MarcusViniciusTEC/PowerSupllyCC_CV/README.md

# PowerSupllyCC_CV

layout fonte CC/CV, controlado por STM32F103 e display 128x64
