MarcusViniciusTEC/PowerSupllyCC_CV/FONTE_V2.kicad_pcb

## KiCad design FONTE_V2.kicad_pcb (2025-01-29)

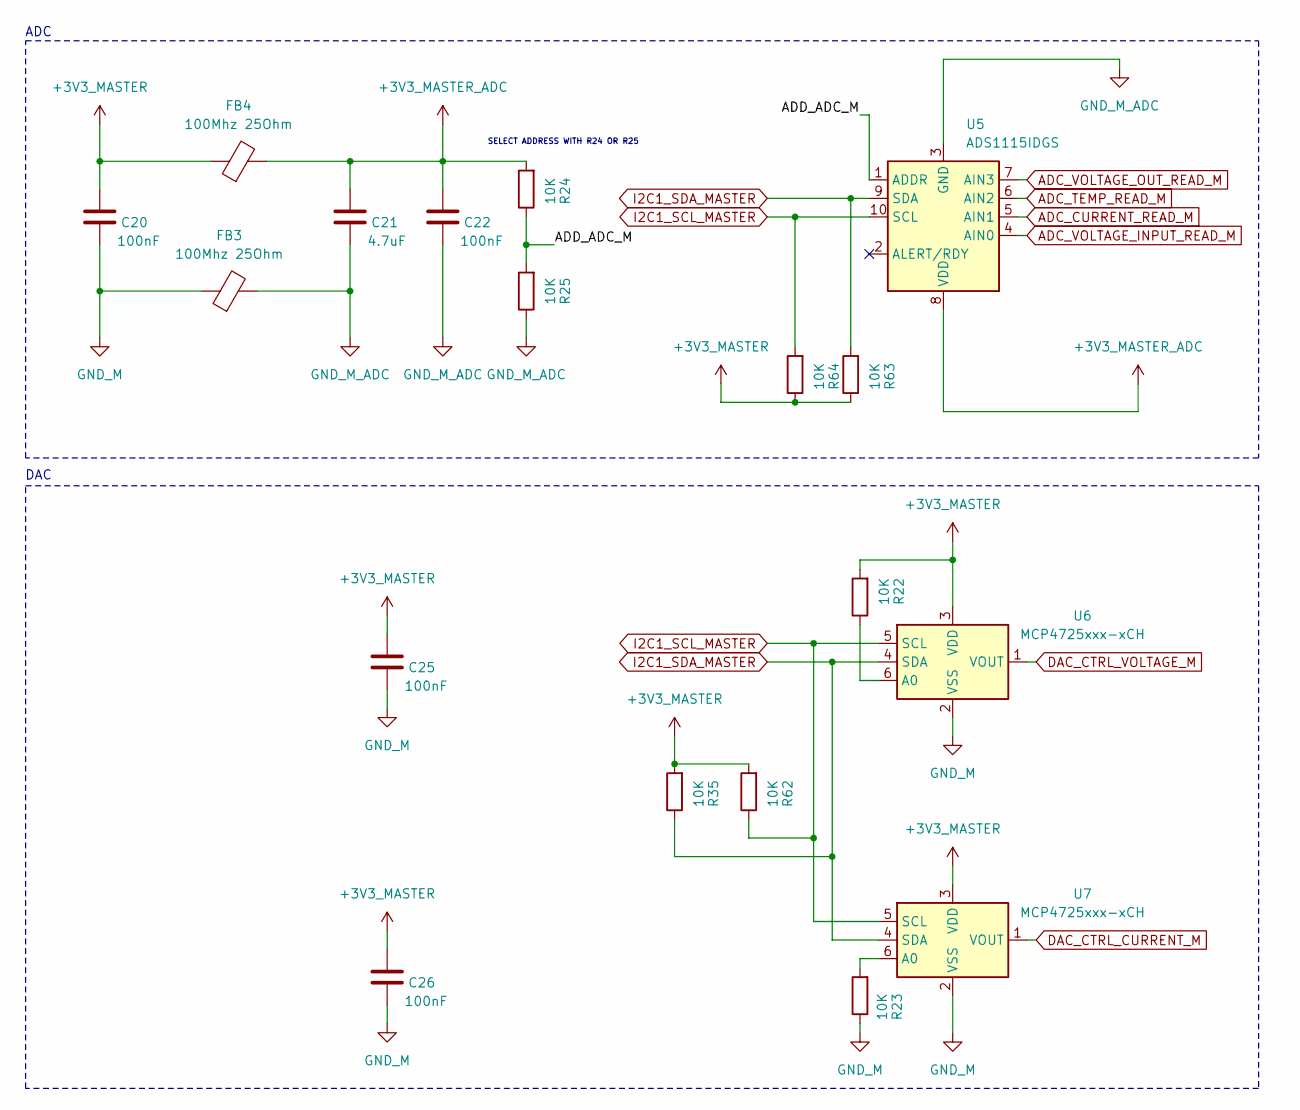
[picture p1: schematic DAC_ADC_MASTER.kicad_sch, FONTE CC/CV MICROCONTROLADA]

Parts:
C20, C22, C25, C26: 100nF; C_0805_2012Metric_Pad1.18x1.45mm_HandSolder
C21: 4.7uF; C_0805_2012Metric_Pad1.18x1.45mm_HandSolder
FB3, FB4: 100Mhz 25Ohm; L_0805_2012Metric_Pad1.15x1.40mm_HandSolder
R22, R23, R24, R25, R35, R62, R63, R64: 10K; R_0805_2012Metric_Pad1.20x1.40mm_HandSolder
U5: ADS1115IDGS; TSSOP-10_3x3mm_P0.5mm
U6, U7: MCP4725xxx-xCH; SOT-23-6

Connections:
+3V3_MASTER: C20.1, C25.1, C26.1, FB4.1, R22.2, R35.2, R62.2, R63.1, R64.1, U6.3 (VDD), U7.3 (VDD); also elsewhere on the board
+3V3_MASTER_ADC: C21.1, C22.1, FB4.2, R24.2, U5.8 (VDD)
/DAC_ADC_MASTER/ADD_ADC_M: R24.1, R25.2, U5.1 (ADDR)
ADC_CURRENT_READ_M: U5.5 (AIN1); also elsewhere on the board
ADC_TEMP_READ_M: U5.6 (AIN2); also elsewhere on the board
ADC_VOLTAGE_INPUT_READ_M: U5.4 (AIN0); also elsewhere on the board
ADC_VOLTAGE_OUT_READ_M: U5.7 (AIN3); also elsewhere on the board
DAC_CTRL_CURRENT_M: U7.1 (VOUT); also elsewhere on the board
DAC_CTRL_VOLTAGE_M: U6.1 (VOUT); also elsewhere on the board
GND_M_ADC: C21.2, C22.2, FB3.2, R25.1, U5.3 (GND)
I2C1_SCL_MASTER: R62.1, R64.2, U5.10 (SCL), U6.5 (SCL), U7.5 (SCL); also elsewhere on the board
I2C1_SDA_MASTER: R35.1, R63.2, U5.9 (SDA), U6.4 (SDA), U7.4 (SDA); also elsewhere on the board
unnamed: R22.1, U6.6 (A0)
unnamed: R23.2, U7.6 (A0)

Notes on the sheet:
SELECT ADDRESS WITH R24 OR R25
ADC
DAC

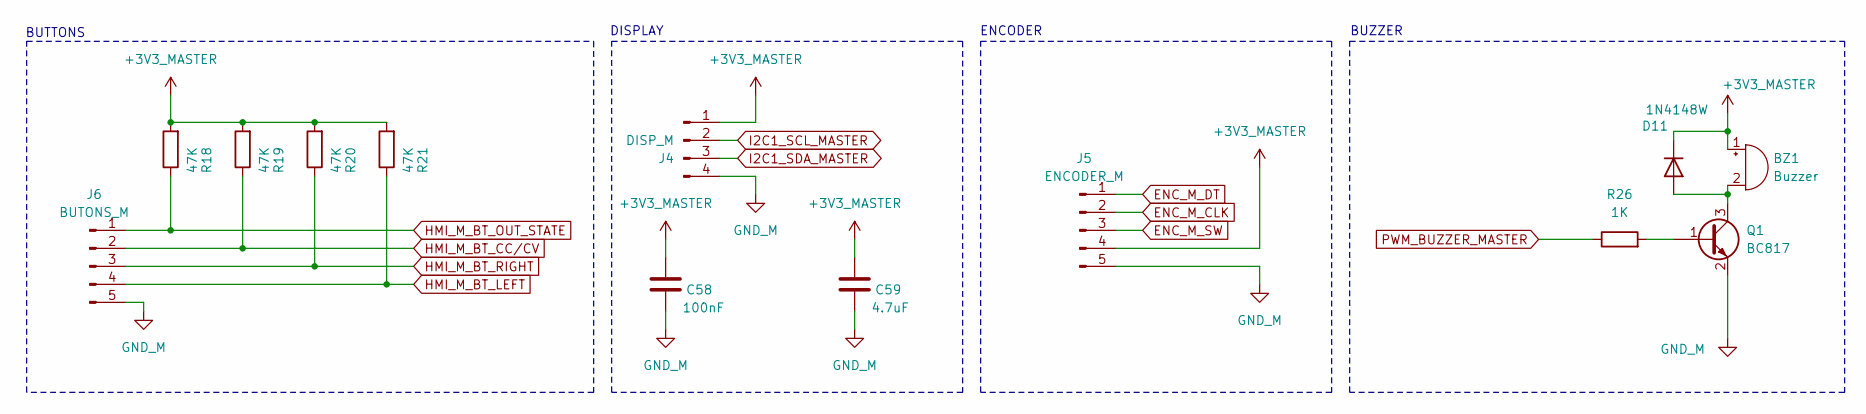
[picture p2: schematic HMI_MASTER.kicad_sch, FONTE CC/CV MICROCONTROLADA]

Parts:
BZ1: Buzzer; Buzzer_12x9.5RM7.6
C58: 100nF; C_0805_2012Metric_Pad1.18x1.45mm_HandSolder
C59: 4.7uF; C_0805_2012Metric_Pad1.18x1.45mm_HandSolder
D11: 1N4148W; D_SOD-123
J4: DISP_M; PinSocket_1x04_P2.54mm_Vertical
J5: ENCODER_M; PinHeader_1x05_P2.54mm_Vertical
J6: BUTONS_M; PinHeader_1x05_P2.54mm_Vertical
Q1: BC817; SOT-23
R18, R19, R20, R21: 47K; R_0805_2012Metric_Pad1.20x1.40mm_HandSolder
R26: 1K; R_0805_2012Metric

Connections:
+3V3_MASTER: BZ1.1 (+), C58.1, C59.1, D11.1 (K), J4.1, J5.4, R18.2, R19.2, R20.2, R21.2; also elsewhere on the board
ENC_M_CLK: J5.2; also elsewhere on the board
ENC_M_DT: J5.1; also elsewhere on the board
ENC_M_SW: J5.3; also elsewhere on the board
HMI_M_BT_CC/CV: J6.2, R19.1; also elsewhere on the board
HMI_M_BT_LEFT: J6.4, R21.1; also elsewhere on the board
HMI_M_BT_OUT_STATE: J6.1, R18.1; also elsewhere on the board
HMI_M_BT_RIGHT: J6.3, R20.1; also elsewhere on the board
I2C1_SCL_MASTER: J4.2; also elsewhere on the board
I2C1_SDA_MASTER: J4.3; also elsewhere on the board
unnamed: BZ1.2 (-), D11.2 (A), Q1.3 (C)
unnamed: Q1.1 (B), R26.2
PWM_BUZZER_MASTER: R26.1; also elsewhere on the board

Notes on the sheet:
BUZZER
DISPLAY
BUTTONS
ENCODER

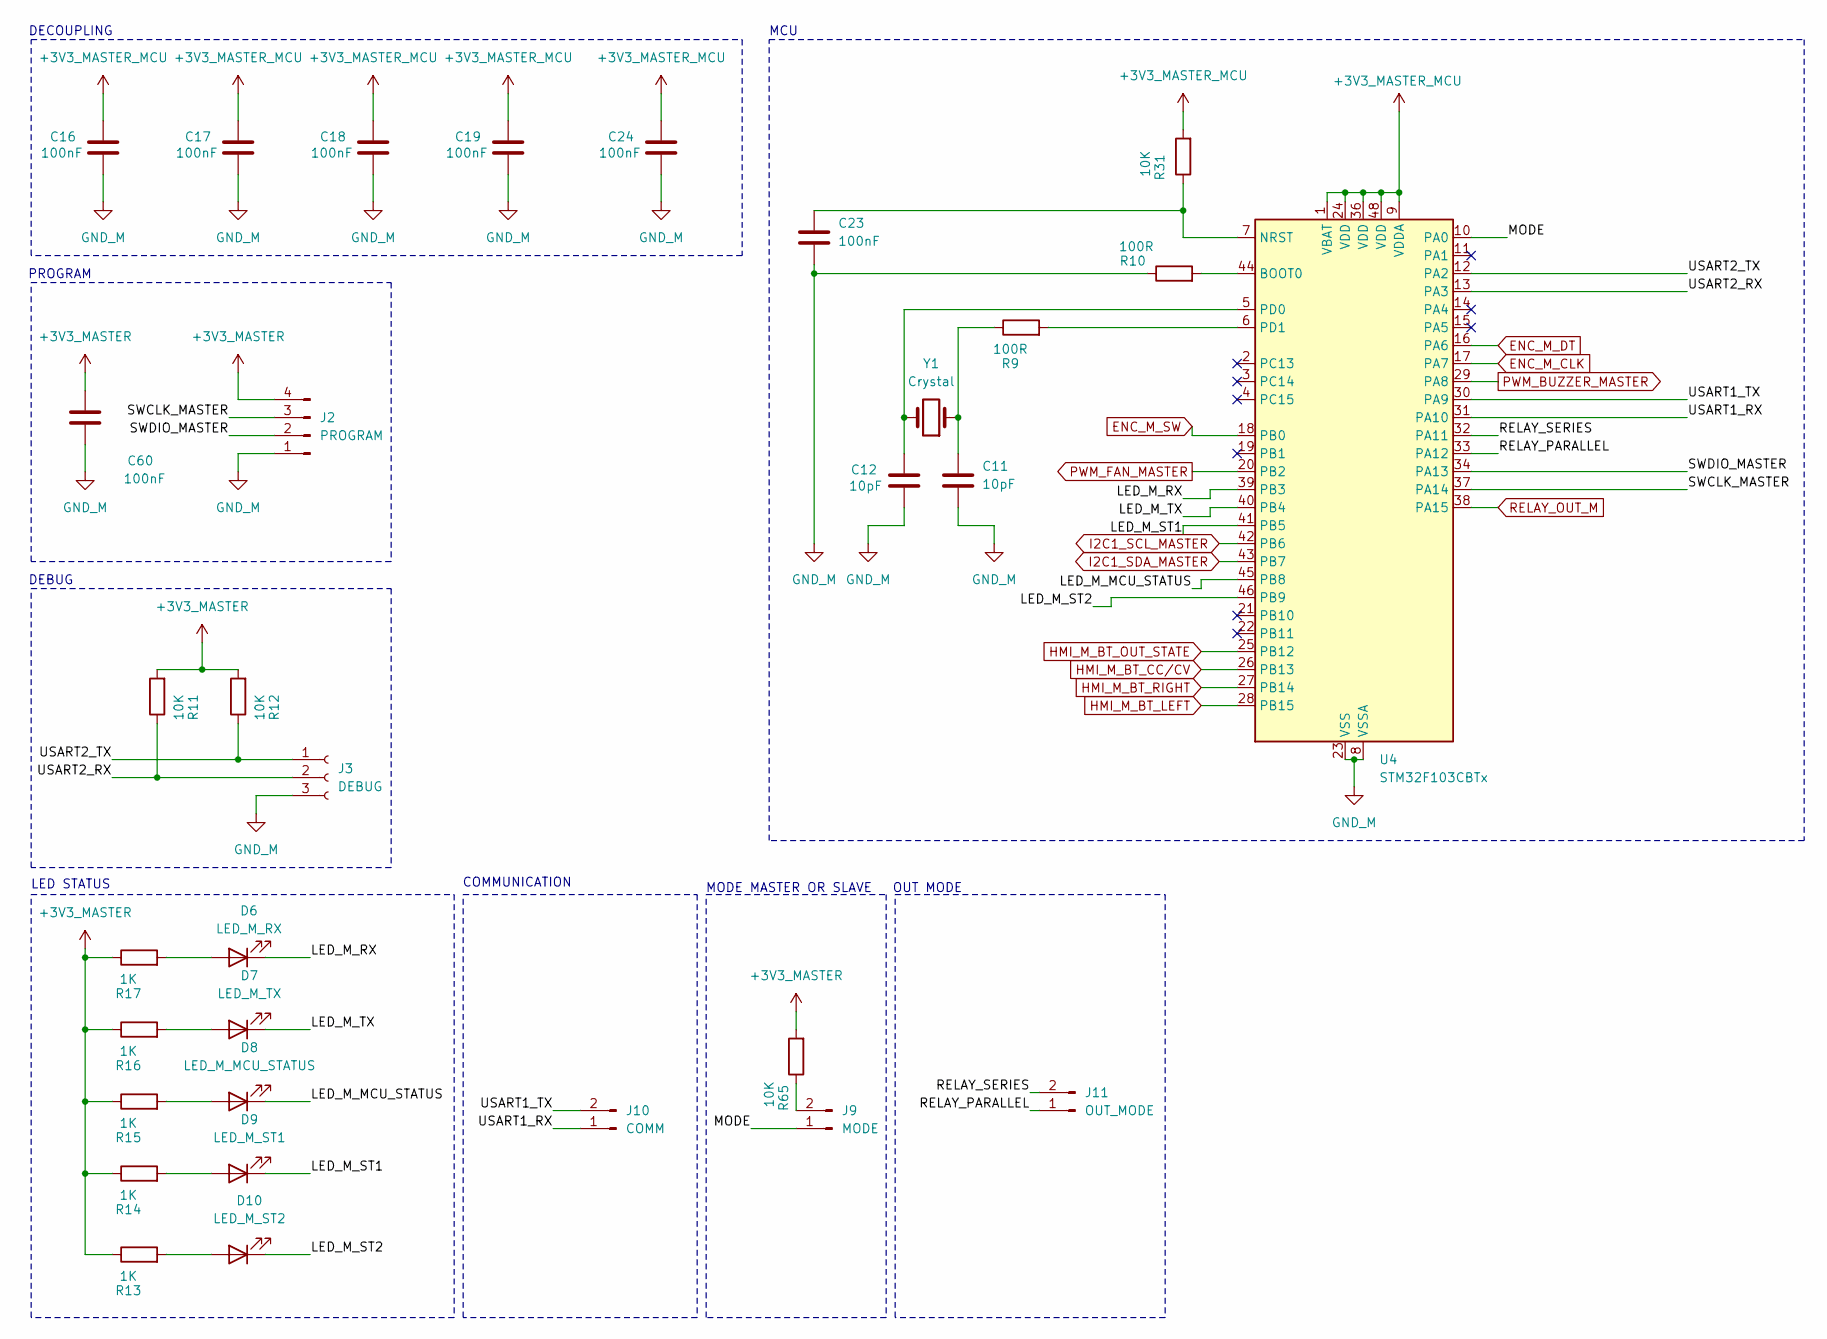
[picture p3: schematic MCU_MASTER.kicad_sch, FONTE CC/CV MICROCONTROLADA]

Parts:
C11, C12: 10pF; C_0805_2012Metric_Pad1.18x1.45mm_HandSolder
C16, C17, C18, C19, C23, C24, C60: 100nF; C_0805_2012Metric_Pad1.18x1.45mm_HandSolder
D6: LED_M_RX; LED_0805_2012Metric_Pad1.15x1.40mm_HandSolder
D7: LED_M_TX; LED_0805_2012Metric_Pad1.15x1.40mm_HandSolder
D8: LED_M_MCU_STATUS; LED_0805_2012Metric_Pad1.15x1.40mm_HandSolder
D9: LED_M_ST1; LED_0805_2012Metric_Pad1.15x1.40mm_HandSolder
D10: LED_M_ST2; LED_0805_2012Metric_Pad1.15x1.40mm_HandSolder
J2: PROGRAM; PinSocket_1x04_P2.54mm_Vertical
J3: DEBUG; PinHeader_1x03_P2.54mm_Vertical
J9: MODE; PinHeader_1x02_P2.54mm_Vertical
J10: COMM; PinHeader_1x02_P2.54mm_Vertical
J11: OUT_MODE; PinHeader_1x02_P2.54mm_Vertical
R9: 100R; R_0805_2012Metric_Pad1.20x1.40mm_HandSolder
R10: 100R; R_0805_2012Metric
R11, R12: 10K; R_0805_2012Metric_Pad1.20x1.40mm_HandSolder
R13, R14, R15, R16, R17: 1K; R_0805_2012Metric_Pad1.20x1.40mm_HandSolder
R31, R65: 10K; R_0805_2012Metric
U4: STM32F103CBTx; LQFP-48_7x7mm_P0.5mm
Y1: Crystal; Crystal_SMD_HC49-SD

Connections:
+3V3_MASTER: C60.1, J2.4, R11.2, R12.2, R13.1, R14.1, R15.1, R16.1, R17.1, R65.2; also elsewhere on the board
+3V3_MASTER_MCU: C16.1, C17.1, C18.1, C19.1, C24.1, R31.2, U4.1 (VBAT), U4.9 (VDDA), U4.24 (VDD), U4.36 (VDD), U4.48 (VDD); also elsewhere on the board
/MCU_MASTER/LED_M_MCU_STATUS: D8.1 (K), U4.45 (PB8)
/MCU_MASTER/LED_M_RX: D6.1 (K), U4.39 (PB3)
/MCU_MASTER/LED_M_ST1: D9.1 (K), U4.41 (PB5)
/MCU_MASTER/LED_M_ST2: D10.1 (K), U4.46 (PB9)
/MCU_MASTER/LED_M_TX: D7.1 (K), U4.40 (PB4)
/MCU_MASTER/MODE: J9.1, U4.10 (PA0)
/MCU_MASTER/RELAY_PARALLEL: J11.1, U4.33 (PA12)
/MCU_MASTER/RELAY_SERIES: J11.2, U4.32 (PA11)
/MCU_MASTER/SWCLK_MASTER: J2.3, U4.37 (PA14)
/MCU_MASTER/SWDIO_MASTER: J2.2, U4.34 (PA13)
/MCU_MASTER/USART1_RX: J10.1, U4.31 (PA10)
/MCU_MASTER/USART1_TX: J10.2, U4.30 (PA9)
/MCU_MASTER/USART2_RX: J3.2, R11.1, U4.13 (PA3)
/MCU_MASTER/USART2_TX: J3.1, R12.1, U4.12 (PA2)
ENC_M_CLK: U4.17 (PA7); also elsewhere on the board
ENC_M_DT: U4.16 (PA6); also elsewhere on the board
ENC_M_SW: U4.18 (PB0); also elsewhere on the board
HMI_M_BT_CC/CV: U4.26 (PB13); also elsewhere on the board
HMI_M_BT_LEFT: U4.28 (PB15); also elsewhere on the board
HMI_M_BT_OUT_STATE: U4.25 (PB12); also elsewhere on the board
HMI_M_BT_RIGHT: U4.27 (PB14); also elsewhere on the board
I2C1_SCL_MASTER: U4.42 (PB6); also elsewhere on the board
I2C1_SDA_MASTER: U4.43 (PB7); also elsewhere on the board
unnamed: C11.1, R9.1, Y1.1
unnamed: D6.2 (A), R17.2
unnamed: D7.2 (A), R16.2
unnamed: D8.2 (A), R15.2
unnamed: D9.2 (A), R14.2
unnamed: D10.2 (A), R13.2
unnamed: J9.2, R65.1
unnamed: R10.2, U4.44 (BOOT0)
unnamed: C12.1, U4.5 (PD0), Y1.2
unnamed: R9.2, U4.6 (PD1)
PWM_BUZZER_MASTER: U4.29 (PA8); also elsewhere on the board
PWM_FAN_MASTER: U4.20 (PB2); also elsewhere on the board
RELAY_OUT_M: U4.38 (PA15); also elsewhere on the board

Notes on the sheet:
MODE MASTER OR SLAVE
DECOUPLING
OUT MODE
LED STATUS
PROGRAM
DEBUG
MCU
COMMUNICATION

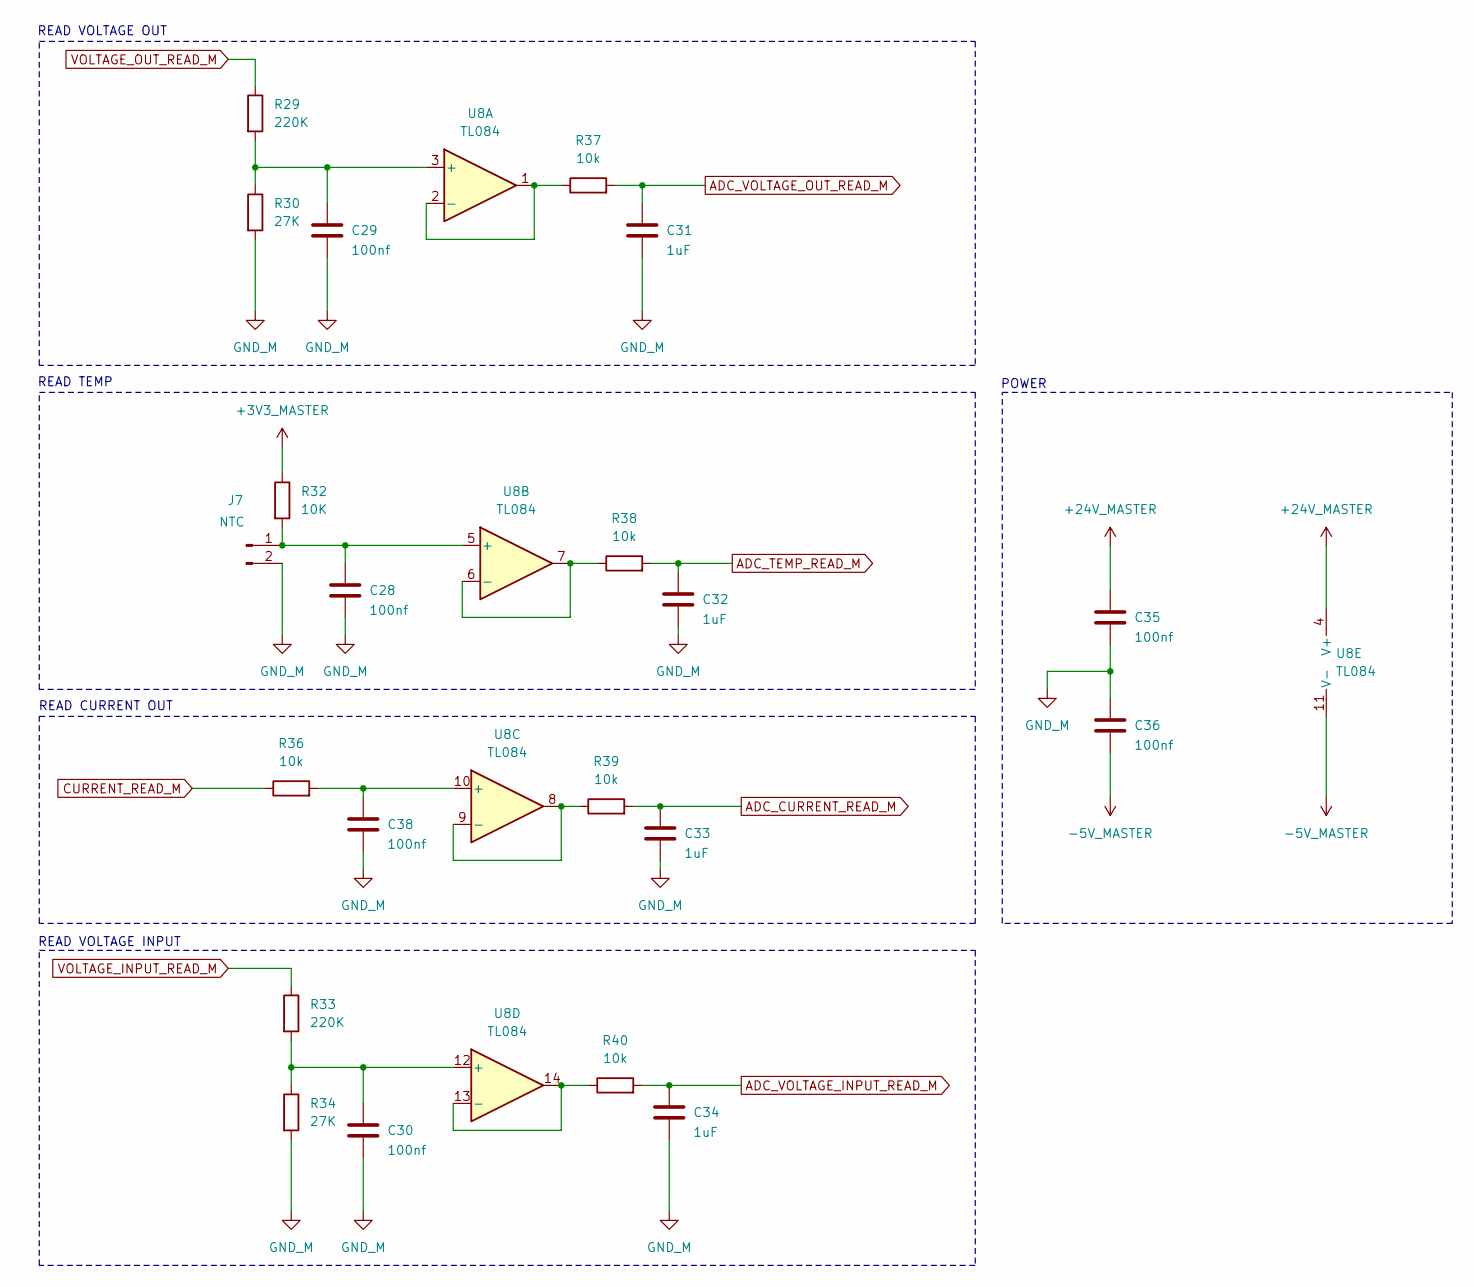
[picture p4: schematic TELEMETRY_MASTER.kicad_sch, FONTE CC/CV MICROCONTROLADA]

Parts:
C28, C29, C30, C35, C36, C38: 100nf; C_0805_2012Metric
C31, C32, C33, C34: 1uF; C_0805_2012Metric
J7: NTC; PinSocket_1x02_P2.54mm_Vertical
R29, R33: 220K; R_0805_2012Metric
R30, R34: 27K; R_0805_2012Metric
R32: 10K; R_0805_2012Metric
R36, R37, R38, R39, R40: 10k; R_0805_2012Metric
U8: TL084; SOIC-14_3.9x8.7mm_P1.27mm

Connections:
+3V3_MASTER: R32.1; also elsewhere on the board
-5V_MASTER: C36.2, U8.11 (V-); also elsewhere on the board
ADC_CURRENT_READ_M: C33.1, R39.2; also elsewhere on the board
ADC_TEMP_READ_M: C32.1, R38.2; also elsewhere on the board
ADC_VOLTAGE_INPUT_READ_M: C34.1, R40.2; also elsewhere on the board
ADC_VOLTAGE_OUT_READ_M: C31.1, R37.2; also elsewhere on the board
CURRENT_READ_M: R36.1; also elsewhere on the board
unnamed: C28.1, J7.1, R32.2, U8.5 (+)
unnamed: C29.1, R29.2, R30.1, U8.3 (+)
unnamed: R37.1, U8.1, U8.2 (-)
unnamed: R38.1, U8.6 (-), U8.7
unnamed: C38.1, R36.2, U8.10 (+)
unnamed: R39.1, U8.8, U8.9 (-)
unnamed: C30.1, R33.2, R34.1, U8.12 (+)
unnamed: R40.1, U8.13 (-), U8.14
VOLTAGE_INPUT_READ_M: C35.1, R33.1, U8.4 (V+); also elsewhere on the board
VOLTAGE_OUT_READ_M: R29.1; also elsewhere on the board

Notes on the sheet:
READ VOLTAGE OUT
POWER
READ TEMP
READ VOLTAGE INPUT
READ CURRENT OUT

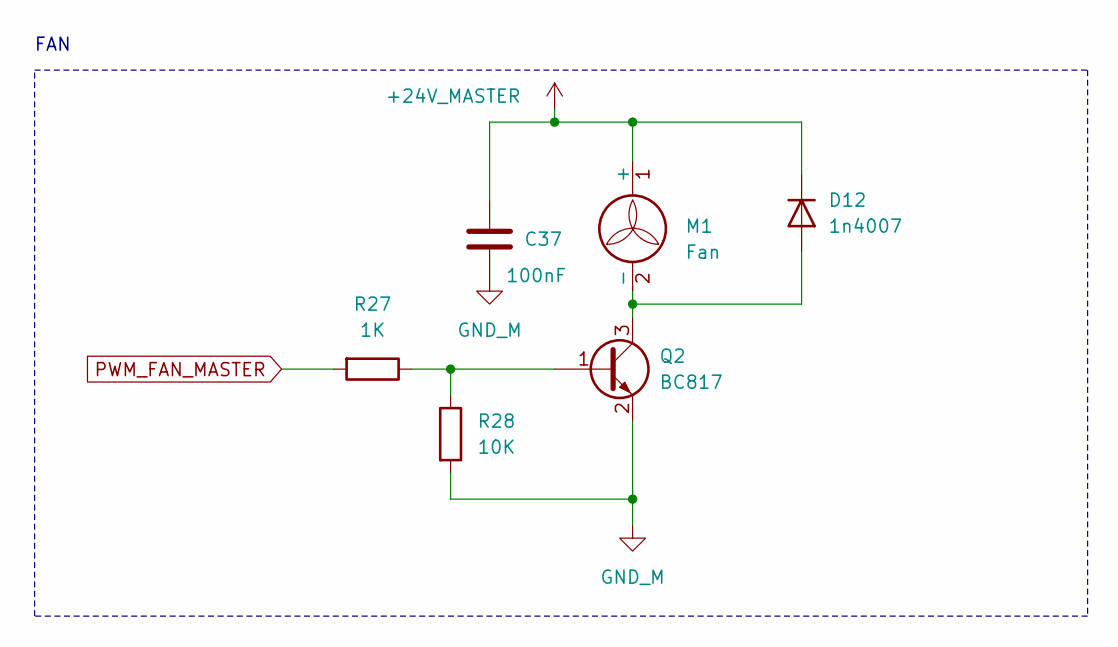
[picture p5: schematic FAN_HEATSINK_MASTER.kicad_sch, FONTE CC/CV MICROCONTROLADA]

Parts:
C37: 100nF; C_0805_2012Metric_Pad1.18x1.45mm_HandSolder
D12: 1n4007; D_SMA_Handsoldering
M1: Fan; PinHeader_1x02_P2.54mm_Vertical
Q2: BC817; SOT-23
R27: 1K; R_0805_2012Metric
R28: 10K; R_0805_2012Metric

Connections:
unnamed: D12.2 (A), M1.2 (-), Q2.3 (C)
unnamed: Q2.1 (B), R27.1, R28.1
PWM_FAN_MASTER: R27.2; also elsewhere on the board
VOLTAGE_INPUT_READ_M: C37.1, D12.1 (K), M1.1 (+); also elsewhere on the board

Notes on the sheet:
FAN

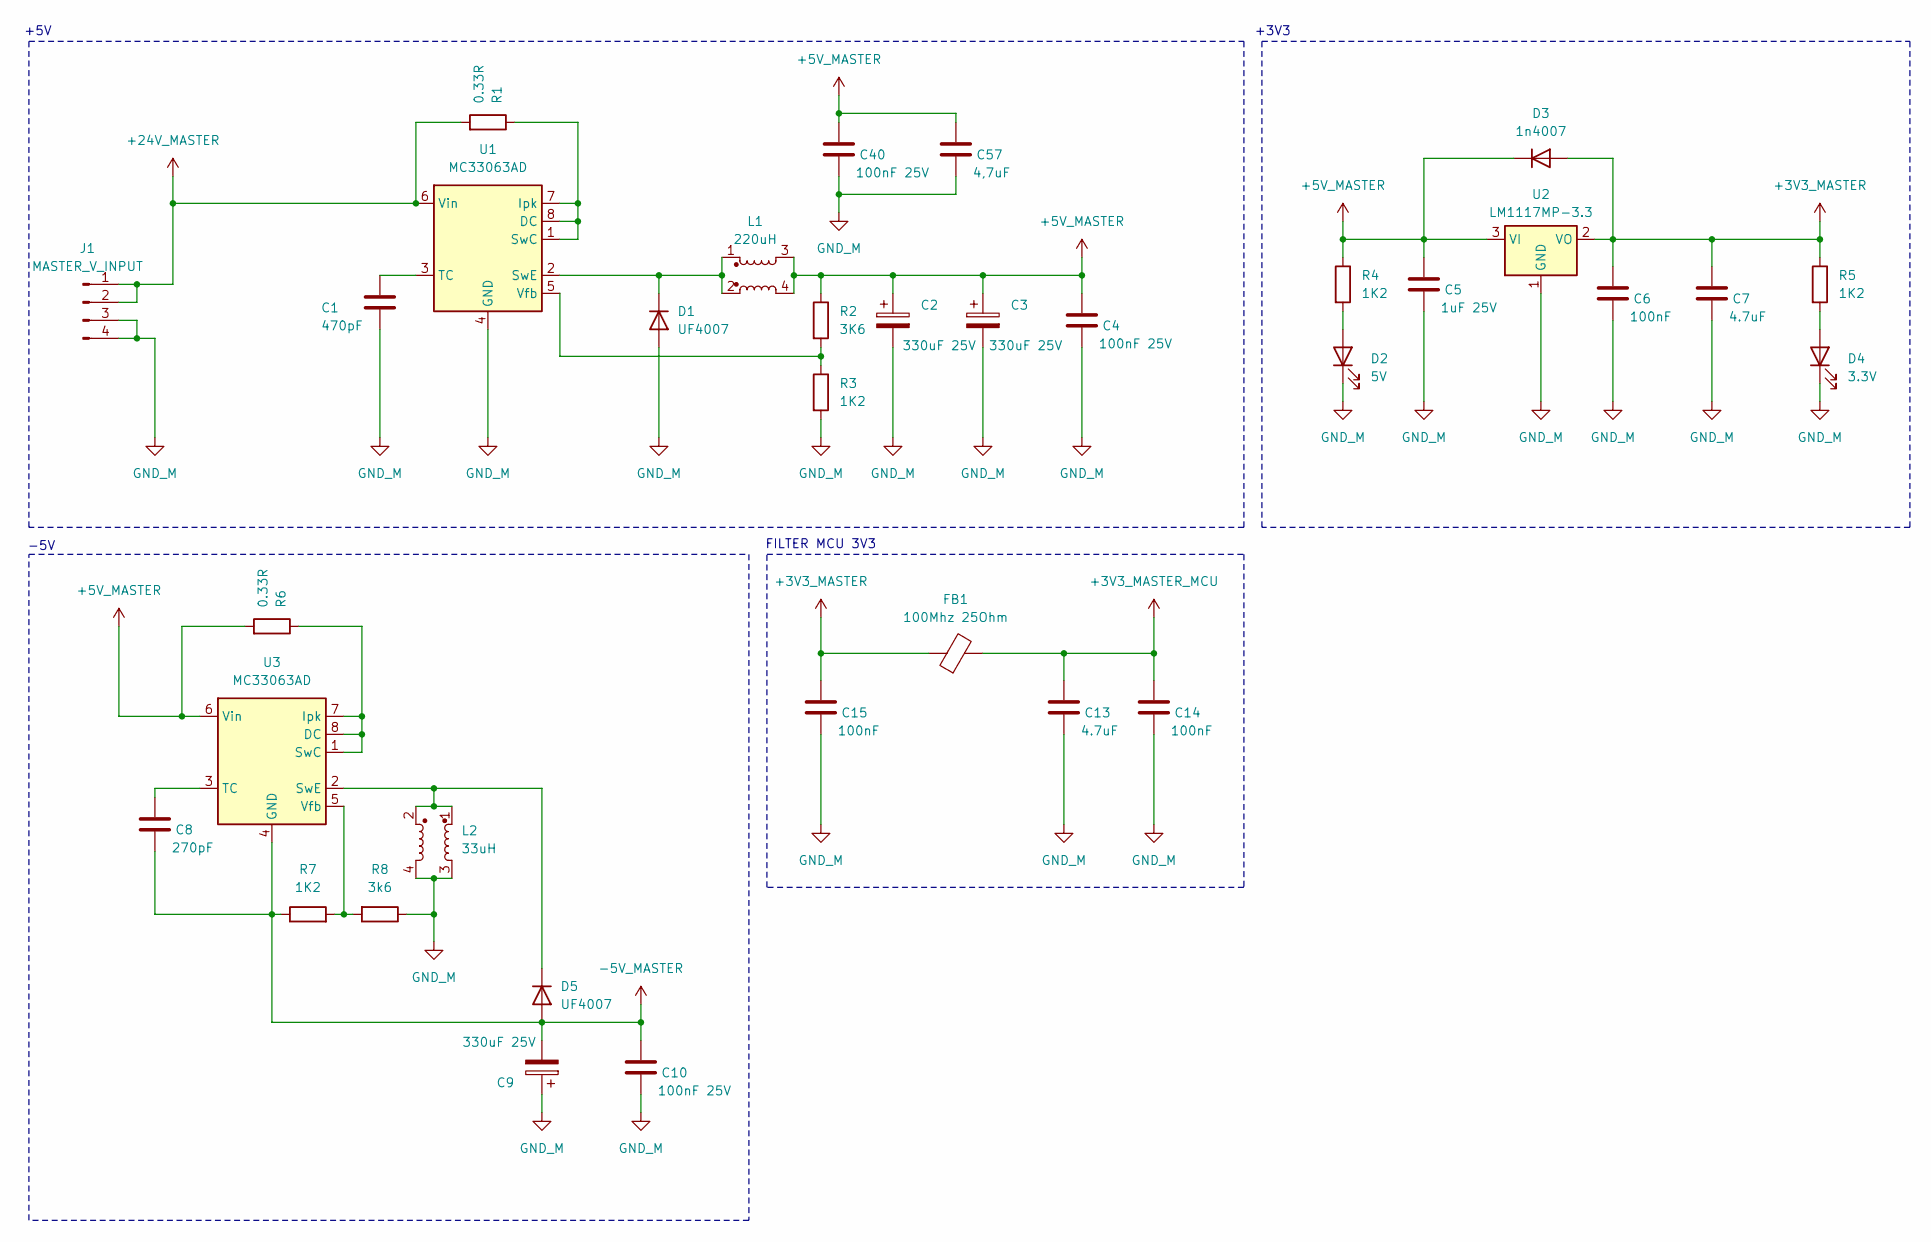
[picture p6: schematic POWER_SUPPLY_MASTER.kicad_sch, FONTE CC/CV MICROCONTROLADA]

Parts:
C1: 470pF; C_0805_2012Metric_Pad1.18x1.45mm_HandSolder
C2, C3, C9: 330uF 25V; CP_Radial_D8.0mm_P3.50mm
C4, C10, C40: 100nF 25V; C_0805_2012Metric_Pad1.18x1.45mm_HandSolder
C5: 1uF 25V; C_0805_2012Metric_Pad1.18x1.45mm_HandSolder
C6, C14, C15: 100nF; C_0805_2012Metric_Pad1.18x1.45mm_HandSolder
C7, C13: 4.7uF; C_0805_2012Metric_Pad1.18x1.45mm_HandSolder
C8: 270pF; C_0805_2012Metric_Pad1.18x1.45mm_HandSolder
C57: 4,7uF; C_0805_2012Metric_Pad1.18x1.45mm_HandSolder
D1, D5: UF4007; D_DO-41_SOD81_P10.16mm_Horizontal
D2: 5V; LED_0805_2012Metric
D3: 1n4007; D_SMA_Handsoldering
D4: 3.3V; LED_0805_2012Metric
FB1: 100Mhz 25Ohm; L_0805_2012Metric_Pad1.15x1.40mm_HandSolder
J1: MASTER_V_INPUT; PhoenixContact_MSTBVA_2,5_4-G-5,08_1x04_P5.08mm_Vertical
L1: 220uH; L_Bourns_SRF1260
L2: 33uH; L_Bourns_SRF1260
R1, R6: 0.33R; R_Axial_DIN0207_L6.3mm_D2.5mm_P10.16mm_Horizontal
R2: 3K6; R_0805_2012Metric_Pad1.20x1.40mm_HandSolder
R3, R4, R5, R7: 1K2; R_0805_2012Metric_Pad1.20x1.40mm_HandSolder
R8: 3k6; R_0805_2012Metric_Pad1.20x1.40mm_HandSolder
U1, U3: MC33063AD; SOIC-8_3.9x4.9mm_P1.27mm
U2: LM1117MP-3.3; TO-252-3_TabPin2

Connections:
+3V3_MASTER: C6.1, C7.1, C15.1, D3.2 (A), FB1.1, R5.1, U2.2 (VO); also elsewhere on the board
+3V3_MASTER_MCU: C13.1, C14.1, FB1.2; also elsewhere on the board
+5V_MASTER: C2.1, C3.1, C4.1, C5.1, C40.1, C57.1, D3.1 (K), L1.3, L1.4, R2.1, R4.1, R6.2, U2.3 (VI), U3.6 (Vin); also elsewhere on the board
-5V_MASTER: C8.2, C9.2, C10.1, D5.2 (A), R7.1, U3.4 (GND); also elsewhere on the board
unnamed: D1.1 (K), L1.1, L1.2, U1.2 (SwE)
unnamed: D2.2 (A), R4.2
unnamed: D4.2 (A), R5.2
unnamed: D5.1 (K), L2.1, L2.2, U3.2 (SwE)
unnamed: R1.1, U1.1 (SwC), U1.7 (Ipk), U1.8 (DC)
unnamed: C1.1, U1.3 (TC)
unnamed: R2.2, R3.1, U1.5 (Vfb)
unnamed: R6.1, U3.1 (SwC), U3.7 (Ipk), U3.8 (DC)
unnamed: C8.1, U3.3 (TC)
unnamed: R7.2, R8.2, U3.5 (Vfb)
VOLTAGE_INPUT_READ_M: J1.1, J1.2, R1.2, U1.6 (Vin); also elsewhere on the board

Notes on the sheet:
FILTER MCU 3V3
+5V
+3V3
-5V

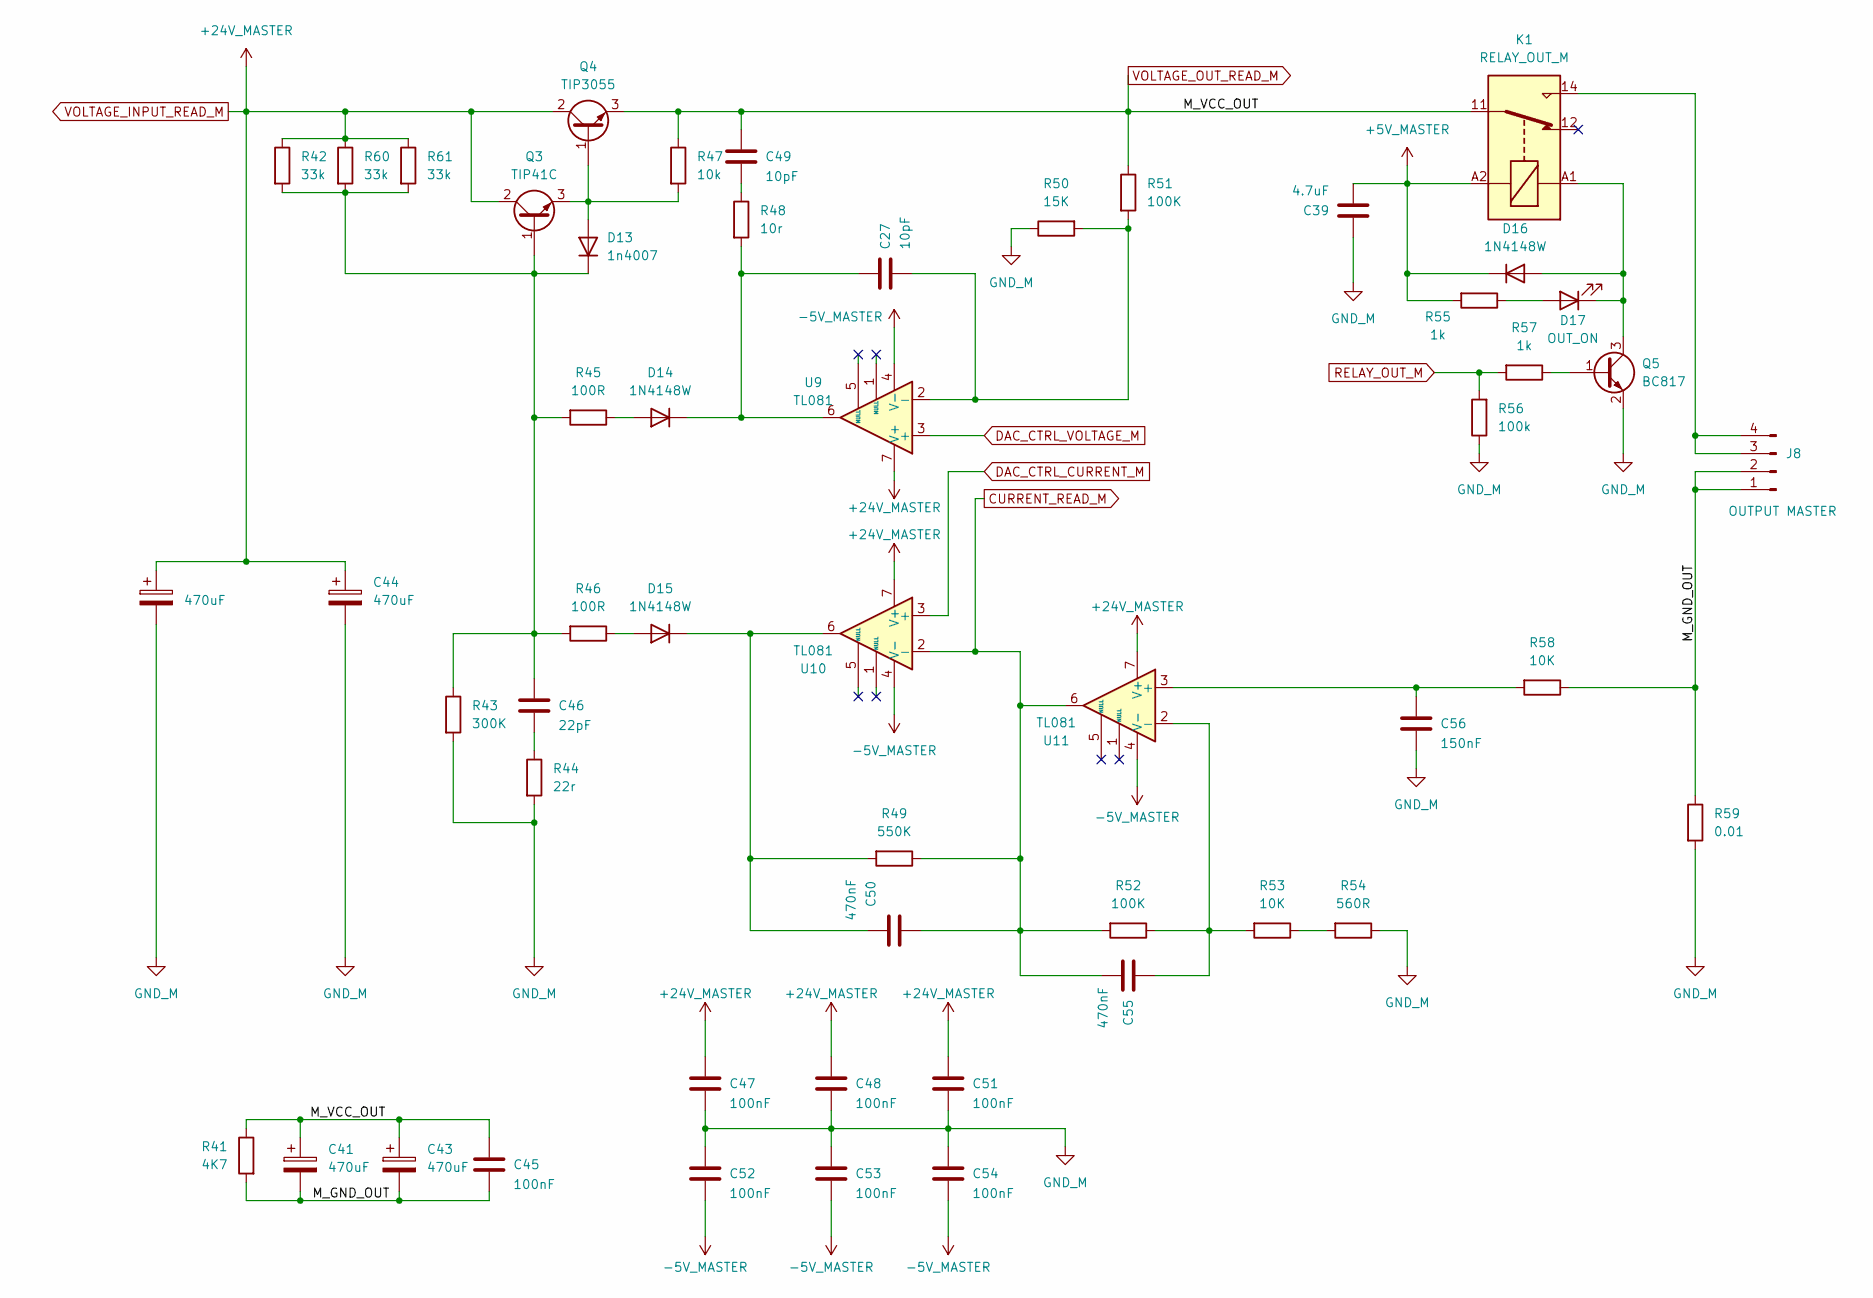
[picture p7: schematic untitled.kicad_sch, FONTE CC/CV MICROCONTROLADA]

Parts:
C27, C49: 10pF; C_0805_2012Metric
C39: 4.7uF; C_0805_2012Metric
C41, C42, C43, C44: 470uF; CP_Radial_D10.0mm_P5.00mm
C45, C47, C48, C51, C52, C53, C54: 100nF; C_0805_2012Metric
C46: 22pF; C_0805_2012Metric_Pad1.18x1.45mm_HandSolder
C50, C55: 470nF; C_0805_2012Metric_Pad1.18x1.45mm_HandSolder
C56: 150nF; C_0805_2012Metric_Pad1.18x1.45mm_HandSolder
D13: 1n4007; D_SMA_Handsoldering
D14, D15, D16: 1N4148W; D_SOD-123
D17: OUT_ON; LED_0805_2012Metric
J8: OUTPUT MASTER; PhoenixContact_MSTBVA_2,5_4-G-5,08_1x04_P5.08mm_Vertical
K1: RELAY_OUT_M; Relay_SPDT_Hongfa_HF3F-L-xx-1ZL1T
Q3: TIP41C; TO-220-3_Vertical
Q4: TIP3055; TO-218-3_Vertical
Q5: BC817; SOT-23
R41: 4K7; R_Axial_DIN0207_L6.3mm_D2.5mm_P10.16mm_Horizontal
R42, R60, R61: 33k; R_0805_2012Metric_Pad1.20x1.40mm_HandSolder
R43: 300K; R_0805_2012Metric_Pad1.20x1.40mm_HandSolder
R44: 22r; R_0805_2012Metric_Pad1.20x1.40mm_HandSolder
R45, R46: 100R; R_0805_2012Metric_Pad1.20x1.40mm_HandSolder
R47: 10k; R_0805_2012Metric_Pad1.20x1.40mm_HandSolder
R48: 10r; R_0805_2012Metric_Pad1.20x1.40mm_HandSolder
R49: 550K; R_0805_2012Metric_Pad1.20x1.40mm_HandSolder
R50: 15K; R_0805_2012Metric_Pad1.20x1.40mm_HandSolder
R51, R52: 100K; R_0805_2012Metric_Pad1.20x1.40mm_HandSolder
R53, R58: 10K; R_0805_2012Metric_Pad1.20x1.40mm_HandSolder
R54: 560R; R_0805_2012Metric_Pad1.20x1.40mm_HandSolder
R55: 1k; R_0805_2012Metric
R56: 100k; R_0805_2012Metric_Pad1.20x1.40mm_HandSolder
R57: 1k; R_0805_2012Metric_Pad1.20x1.40mm_HandSolder
R59: 0.01; R_2512_6332Metric_Pad1.40x3.35mm_HandSolder
U9, U10, U11: TL081; SOIC-8_3.9x4.9mm_P1.27mm

Connections:
+5V_MASTER: C39.2, D16.1 (K), K1.A2, R55.2; also elsewhere on the board
-5V_MASTER: C52.2, C53.2, C54.2, U9.4 (V-), U10.4 (V-), U11.4 (V-); also elsewhere on the board
/REG_POWER_SUPPLY/M_GND_OUT: C41.2, C43.2, C45.2, J8.1, J8.2, R41.2, R58.1, R59.1
CURRENT_READ_M: C50.1, C55.2, R49.1, R52.2, U10.2 (-), U11.6; also elsewhere on the board
DAC_CTRL_CURRENT_M: U10.3 (+); also elsewhere on the board
DAC_CTRL_VOLTAGE_M: U9.3 (+); also elsewhere on the board
unnamed: C46.2, R44.1
unnamed: C49.2, R48.1
unnamed: D13.2 (A), Q3.3 (E), Q4.1 (B), R47.2
unnamed: C46.1, D13.1 (K), Q3.1 (B), R42.2, R43.1, R45.2, R46.2, R60.2, R61.2
unnamed: D14.2 (A), R45.1
unnamed: C27.1, D14.1 (K), R48.2, U9.6
unnamed: D15.2 (A), R46.1
unnamed: C50.2, D15.1 (K), R49.2, U10.6
unnamed: D16.2 (A), D17.1 (K), K1.A1, Q5.3 (C)
unnamed: D17.2 (A), R55.1
unnamed: J8.3, J8.4, K1.14
unnamed: Q5.1 (B), R57.1
unnamed: R53.1, R54.2
unnamed: C27.2, R50.2, R51.2, U9.2 (-)
unnamed: C56.1, R58.2, U11.3 (+)
unnamed: C55.1, R52.1, R53.2, U11.2 (-)
RELAY_OUT_M: R56.2, R57.2; also elsewhere on the board
VOLTAGE_INPUT_READ_M: C42.1, C44.1, C47.1, C48.1, C51.1, Q3.2 (C), Q4.2 (C), R42.1, R60.1, R61.1, U9.7 (V+), U10.7 (V+), U11.7 (V+); also elsewhere on the board
VOLTAGE_OUT_READ_M: C41.1, C43.1, C45.1, C49.1, K1.11, Q4.3 (E), R41.1, R47.1, R51.1; also elsewhere on the board

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
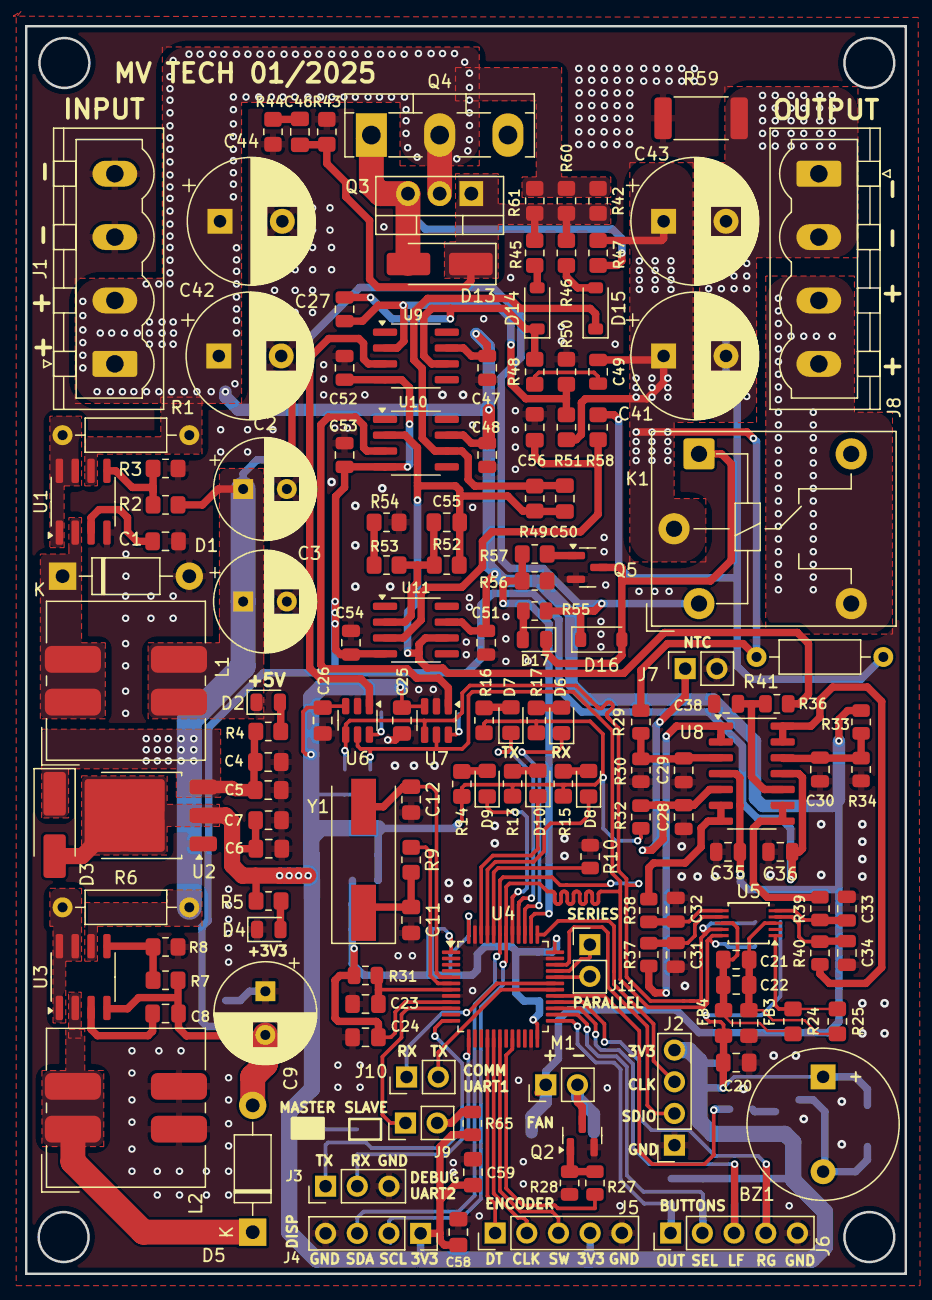
[picture p8: board FONTE_V2.kicad_pcb from above]

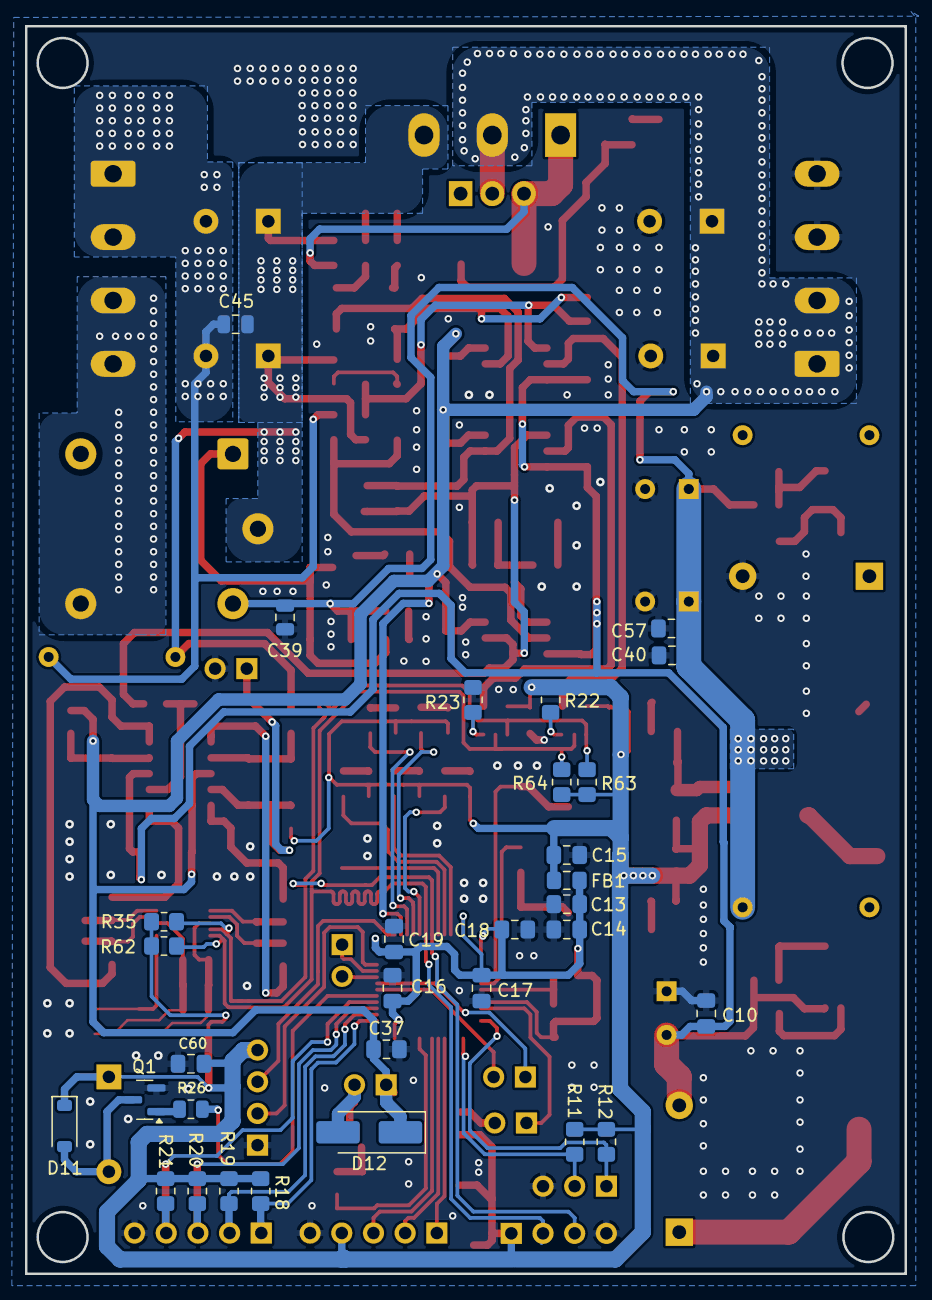
[picture p9: board FONTE_V2.kicad_pcb from below]

Board: 2 copper layers, 70.5 x 100.0 mm, 178 parts (31 on the bottom side), 95 nets.
